berlin6699/2023-B/README.md

# 2023电赛B题
* 本题采用NE555振荡电路
* 实测精度1mm，最低测量7cm
* 成本低，速度快
* 一天半即可做完
