berlin6699/2023-B/项目介绍/项目介绍.pdf

### 电赛2023B题

任务

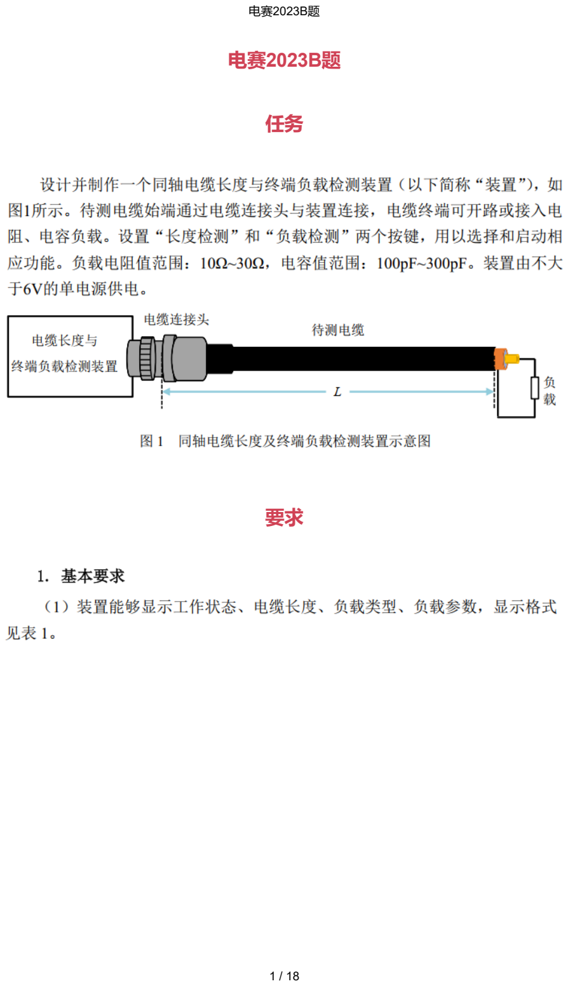
[picture p3: page 1]

要求

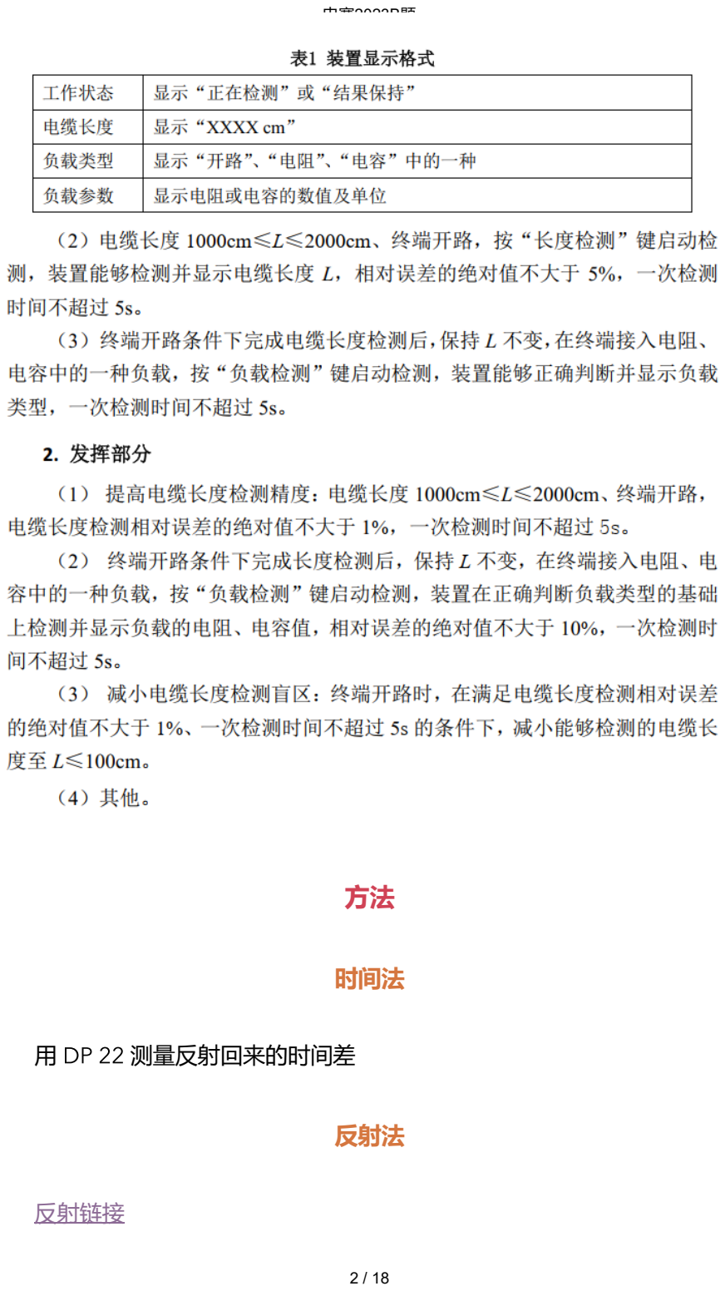
[picture p4: page 2]

方法

# 时间法

# 用 DP 22 测量反射回来的时间差

# 反射法

# 反射链接 (https://bbs.eeworld.com.cn/thread-1252184-1-1.html)

# 555 震荡法

# 最后选择的方法，事实证明非常好用，非常简单，非常精准

# 总的思想是先用 NE555 振荡出一个频率合适的方波（大概 100 多 k）， 再把传输线看成一个大电容（事实上理论就是如此）并联到 555 的电容端， 通过新振荡出来的频率来测量这时候传输线的长度

# 我们目前有三个量

# 这时候如果把 x 轴当作振荡频率，y 轴当作二者的乘积 那么可以发现，画出来的图形及其的线性 如下图所示 这个时候就可以通过频率精准的测出长度

线长

# 振荡频率 线长和震荡频率的乘积

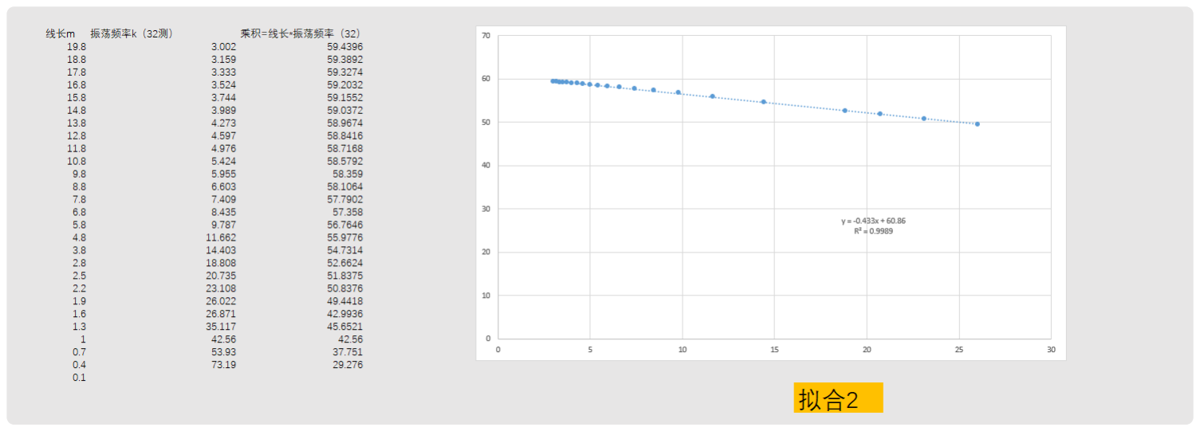
[picture p5: figure]

# 至于线缆单位长度的电容，也可以通过 NE555 的振荡公式算出来后进行

拟合

# 可以看到，R² 直接干到 1 了，很准，说明电缆等效电容分布很均匀

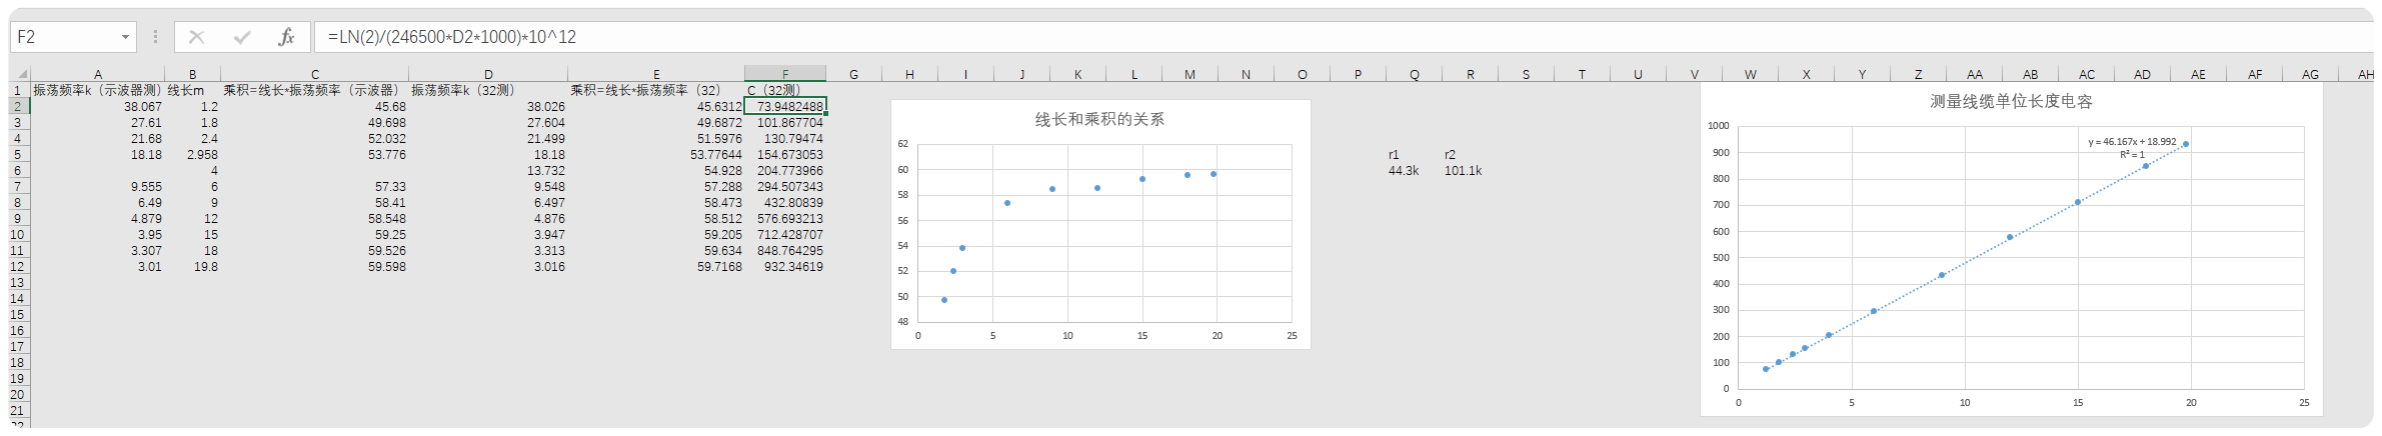
[picture p6: figure]

# 之后判断负载可以通过测量接入负载后的振荡频率来区分

# 振荡频率和接入前基本一致是开路 振荡频率比接入前低是电容 振荡频率变成 0 是电阻 代码如下

int judge_type(float connect_freq)

{

## //如果不震荡了，那就是接入了电阻

if(connect_freq == 0)

{

return r_flag;

}

## //如果频率和开路的基本频率基本一样，那么就是开路，这个容忍度是40kHz

else if((basic_freq-connect_freq)<40e3)

# 其他说明

{

return open_flag;

}

## //否则就是电容接入

else

{

return c_flag;

}

}

# 电容测量就根据变化的电容值来测量，接入电容相当于并联了电 容，直接换算成传输线的长度来运算，最后反解回电容

# 电阻测量就加入一个继电器，判断为电阻就切换一下测量电路，然 后根据分压法测量

# TIM 的捕获频率设置了 2 分频（84 MHz），这个频率越大那么频率测量 的就越精确，但没有取 1 分频是因为 168 M 太快了，会导致 65535 的 最大重装载溢出，造成某些低频无法测量，所以选择了 2 分频 还有一些拟合的数据见最后的整体代码

# 整体代码

# 宏定义

/* USER CODE BEGIN PD */

## //定义判断状态标志位

#define open_flag 0

#define c_flag 1

#define r_flag 2

## //定义连接负载板电容

#define add_C 1.9

## //定义基础开路震荡频率

#define basic_freq 132e3

## //乘积和振荡频率的一次函数关系

#define freq_slope -0.465

#define freq_intercept 60.803

## //线缆等效电容线密度

#define line_density_slope 46.167

#define line_density_intercept 18.992

## //定义分压测量电阻的串联已知电阻

# 全局变量

#define Rs 20.5

/* USER CODE END PD */

/* USER CODE BEGIN PV */

int time[3];

int i = 0;

int flag = 1;

## //定义第一次测量电路频率

double freq = 0;

## //定义第一次测量的乘积=线长*振荡频率

double sum = 0;

## //定义第一次测量线长

double length = 0;

## //定义第一次测量电缆的电容值

double C = 0;

## //定义接入负载后的振荡频率

double connect_freq = 0;

函数

# 自定义函数

double R_vol = 0;

## //负载类型判断

int type = 0;

/* USER CODE END PV */

/* USER CODE BEGIN PFP */

## //判断负载类型

int judge_type(float connect_freq);

## //第一次计算电缆长度

void calculate_length();

## //第二次计算

void recalculate();

/* USER CODE END PFP */

/* USER CODE BEGIN 4 */

int judge_type(float connect_freq)

{

## //如果不震荡了，那就是接入了电阻

if(connect_freq == 0)

{

return r_flag;

}

## //如果频率和开路的基本频率基本一样，那么就是开路，这个容忍度是40kHz

else if((basic_freq-connect_freq)<40e3)

{

return open_flag;

}

## //否则就是电容接入

else

{

return c_flag;

}

}

void calculate_length()

{

## //第一次计算，算出振荡频率、线长和等效电容

time[2]=time[1]-time[0];

printf("%d\r\n",time[2]);

freq= (84*1000000)/time[2];

printf("freq=%f k\r\n",freq/1000);

sum = freq_slope*freq/1000+freq_intercept;

length = sum/(freq/1000);

printf("length=%f\r\n",length);

C = length*46.167+18.992;

printf("C=%f\r\n",C);

}

void recalculate()

{

## //第二次计算，考虑到可能不震荡从而触发不了输入捕获，先把两个time置

零

time[1] = time[0] = 0;

i = 0;

__HAL_TIM_SET_COUNTER(&htim1,0);

HAL_Delay(1000);

# TIM 回调函数

time[2]=time[1]-time[0];

## //如果算出来是0，那说明没有触发输入捕获，这样就说明没有震荡，接入了

电阻

### if(time[2] == 0)

{

connect_freq = 0;

printf("电阻");

}

## //触发了输入捕获就是开路或者接入电容，可以算出来振荡频率

else

{

connect_freq= (84*1000000)/time[2];

}

}

/* USER CODE END 4 */

/* USER CODE BEGIN 0 */

void HAL_TIM_IC_CaptureCallback(TIM_HandleTypeDef *htim)

{

// __HAL_TIM_SET_COUNTER(&htim1,0);

if(i==0)

{

time[i] = HAL_TIM_ReadCapturedValue(&htim1, TIM_CHANNEL_3);

i++;

}

else if(i==1)

{

time[i] = HAL_TIM_ReadCapturedValue(&htim1, TIM_CHANNEL_3);

i++;

}

else

{

return;

}

# 主函数

}

/* USER CODE END 0 */

int main(void)

{

/* USER CODE BEGIN 1 */

/* USER CODE END 1 */

/* MCU Configuration----------------------------------------*/

/* Reset of all peripherals, Initializes the Flash interface

and the Systick. */

HAL_Init();

/* USER CODE BEGIN Init */

/* USER CODE END Init */

/* Configure the system clock */

SystemClock_Config();

/* USER CODE BEGIN SysInit */

/* USER CODE END SysInit */

/* Initialize all configured peripherals */

MX_GPIO_Init();

MX_USART1_UART_Init();

MX_DAC_Init();

MX_TIM3_Init();

MX_TIM1_Init();

/* USER CODE BEGIN 2 */

//初始化ADS8688

ADS8688_Init_Mult();

## //初始化定时器一些参数

HAL_TIM_Base_Start(&htim1);

HAL_TIM_IC_Start_IT(&htim1, TIM_CHANNEL_3);

__HAL_TIM_SET_COUNTER(&htim1,0);

## //初始化继电器

HAL_GPIO_WritePin(Relays_GPIO_Port, Relays_Pin, RESET);

/* USER CODE END 2 */

/* Infinite loop */

/* USER CODE BEGIN WHILE */

## //适当延时，使输入捕获频率测量完毕

HAL_Delay(1000);

## //计算第一次的参数：freq,C,length

calculate_length();

HAL_Delay(1000);

## //进行第二次计算

recalculate();

## //进行负载判断

type = judge_type(connect_freq);

if(type == c_flag)

{

## //计算连接后的乘积

double sum_connect = (-0.4052)*connect_freq/1000+60.846;

## //计算连接后的等效电缆长度

double length_connect = sum_connect/(connect_freq/1000);

## //根据电缆电容线密度，由等效长度算出等效电容大小

double C_connect =

length_connect*line_density_slope+line_density_intercept;

## //算出来的C不对，需要拟合得出正确的结果

double real_c = 2.0755*(C_connect-C-add_C)+8.7644;

printf("newC=%f\r\n",real_c);

}

else if(type == r_flag)

{

## //写后续切换继电器操作

HAL_GPIO_WritePin(Relays_GPIO_Port, Relays_Pin, SET);

HAL_Delay(100);

## //分压法测电阻阻值，用8688采集电压更准确

R_vol = get_vol(1);

printf("R_vol=%f\r\n",R_vol);

double R = (R_vol*Rs)/(5-R_vol);

printf("R=%f\r\n",R);

}

else

{

## //开路，什么也不操作

}

while (1)

{

}

/* USER CODE END WHILE */

/* USER CODE BEGIN 3 */

/* USER CODE END 3 */

}
