berlin6699/2023-B/软件/整体工程（带串口屏）/2023B/Core/Src/main.c

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
/* Includes ------------------------------------------------------------------*/
#include "main.h"
#include "dac.h"
#include "tim.h"
#include "usart.h"
#include "gpio.h"

/* USER CODE BEGIN Includes */
#include <stdio.h>
#include "math.h"
#include "arm_math.h"
#include "ADS8688.h"
#include "tjc_usart_hmi.h"

/* USER CODE END Includes */

/* USER CODE BEGIN PD */
//定义判断状态标志位
#define open_flag 0
#define c_flag 1
#define r_flag 2

//定义连接负载板电容
#define add_C 1.9

//定义基础开路振荡频率
#define basic_freq 132e3

//乘积和振荡频率的一次函数关关系
#define freq_slope -0.465
#define freq_intercept 60.803

//线缆等效电容线密度
#define line_density_slope 46.167
#define line_density_intercept 18.992

//定义分压测量电阻的串联已知电阻
#define Rs 20.5
/* USER CODE END PD */


/* USER CODE BEGIN PV */
int time[3];
int i = 0;
int flag = 1;

//定义第一次测量电路频率
double freq = 0;
//定义第一次测量的乘积=线长*振荡频率
double sum = 0;
//定义第一次测量线度
double length = 0;
//定义第一次测量电缆的电容值
double C = 0;

//定义接入负载后的振荡频率
double connect_freq = 0;

double R_vol = 0;
//负载类型判断
int type = 0;
/* USER CODE END PV */

void SystemClock_Config(void);
/* USER CODE BEGIN PFP */
//判断负载类型
int judge_type(float connect_freq);

//第一次计算电缆长度
void calculate_length();

//第二次计算
void recalculate();
/* USER CODE END PFP */

/* USER CODE BEGIN 0 */

void HAL_TIM_IC_CaptureCallback(TIM_HandleTypeDef *htim)
{
//	__HAL_TIM_SET_COUNTER(&htim1,0);

	if(i==0)
	{
		time[i] = HAL_TIM_ReadCapturedValue(&htim1, TIM_CHANNEL_3);
		i++;
	}
	else if(i==1)
	{
		time[i] = HAL_TIM_ReadCapturedValue(&htim1, TIM_CHANNEL_3);
		i++;
	}
	else
	{
		return;
	}

}
/* USER CODE END 0 */

/**
  * @brief  The application entry point.
  * @retval int
  */
int main(void)
{

  /* MCU Configuration--------------------------------------------------------*/

  /* Reset of all peripherals, Initializes the Flash interface and the Systick. */
  HAL_Init();

  /* Configure the system clock */
  SystemClock_Config();

  /* Initialize all configured peripherals */
  MX_GPIO_Init();
  MX_USART1_UART_Init();
  MX_DAC_Init();
  MX_TIM3_Init();
  MX_TIM1_Init();
  MX_USART3_UART_Init();
  /* USER CODE BEGIN 2 */
  //初始化ADS8688
  ADS8688_Init_Mult();
  initRingBuff();
  HAL_UART_Receive_IT(&huart3,RxBuff,1);
  //初始化继电器
  HAL_GPIO_WritePin(Relays_GPIO_Port, Relays_Pin, RESET);

  /* USER CODE END 2 */

  /* Infinite loop */
  /* USER CODE BEGIN WHILE */
//  //适当延时，使输入捕获频率测量完毕
//  HAL_Delay(1000);
//  //计算第一次的参数：freq,C,length
//  calculate_length();
//
//  HAL_Delay(1000);
//
//  //进行第二次计算
//  recalculate();
//  //进行负载判断
//  type = judge_type(connect_freq);
//
//  if(type == c_flag)
//  {
//	  //计算连接后的乘积
//	  double sum_connect = (-0.4052)*connect_freq/1000+60.846;
//	  //计算连接后的等效电缆长度
//	  double length_connect = sum_connect/(connect_freq/1000);
//	  //根据电缆电容线密度，由等效长度算出等效电容大小
//	  double C_connect = length_connect*line_density_slope+line_density_intercept;
//	  //算出来的C不对，需要拟合得出正确的结果
//	  double real_c = 2.0755*(C_connect-C-add_C)+8.7644;
//	  printf("newC=%f\r\n",real_c);
//  }
//  else if(type == r_flag)
//  {
//	 //写后续切换继电器操作
//  	 HAL_GPIO_WritePin(Relays_GPIO_Port, Relays_Pin, SET);
//  	 HAL_Delay(100);
//
//  	 //分压法测电阻阻值，ADS8688采集电压更准确
//  	 R_vol = get_vol(1);
//	 printf("R_vol=%f\r\n",R_vol);
//
// 	 double R = (R_vol*Rs)/(5-R_vol);
// 	 printf("R=%f\r\n",R);
//  }
//  else
//  {
//	  //开路，什么也不操作
//  }

    while (1)
  {

    	TJC_USART();//等待按键按下

  }


    /* USER CODE END WHILE */

}

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
/* USER CODE BEGIN 4 */
int judge_type(float connect_freq)
{
	//如果不震荡了，那就是接入了电阻
	if(connect_freq == 0)
	{
		return r_flag;
	}
	//如果频率和开路的基本频率基本一样，那么就是开路，这个容忍度是40kHz
	else if((freq-connect_freq)<4e3)
	{
		return open_flag;
	}
	//否则就是电容接入
	else
	{
		return c_flag;
	}
}


void calculate_length()
{
	//继电器复位
	HAL_GPIO_WritePin(Relays_GPIO_Port, Relays_Pin, RESET);

	//等待继电器稳定
	HAL_Delay(300);
	i = 0;
    HAL_TIM_Base_Start(&htim1);
    HAL_TIM_IC_Start_IT(&htim1, TIM_CHANNEL_3);
    __HAL_TIM_SET_COUNTER(&htim1,0);
    HAL_Delay(100);
	//第一次计算，算出振荡频率、线长和等效电容
	time[2]=time[1]-time[0];
	printf("%d\r\n",time[2]);
	freq= (84*1000000)/time[2];
	printf("freq=%f k\r\n",freq/1000);
	sum = freq_slope*freq/1000+freq_intercept;
	length = sum/(freq/1000);
	printf("length=%f\r\n",length);
	C = length*46.167+18.992;
	printf("C=%f\r\n",C);
	HAL_TIM_Base_Stop(&htim1);
	HAL_TIM_IC_Stop_IT(&htim1, TIM_CHANNEL_3);
}

void recalculate()
{
	//第二次计算，考虑到可能不振荡从而触发不了输入捕获，先把两个time置零
	time[1] = time[0] = 0;
	i = 0;
    HAL_TIM_Base_Start(&htim1);
    HAL_TIM_IC_Start_IT(&htim1, TIM_CHANNEL_3);
    __HAL_TIM_SET_COUNTER(&htim1,0);

	HAL_Delay(100);
	time[2]=time[1]-time[0];

	//如果算出来是0，那说明没有触发输入捕获，这样就说明没有震荡，接入了电阻
	if(time[2] == 0)
	{
		connect_freq = 0;
		printf("电阻");
	}
	//触发了输入捕获就是开路或者接入电容，可以算出来振荡频率
	else
	{
		connect_freq= (84*1000000)/time[2];
	}
	HAL_TIM_Base_Stop(&htim1);
	HAL_TIM_IC_Stop_IT(&htim1, TIM_CHANNEL_3);
}

void TJC_USART()
{
	while (usize >= 6)
	{
		// 校验帧头帧尾是否匹配
		if (u(0) != 0x55 || u(3) != 0xff || u(4) != 0xff || u(5) != 0xff)
		{
			// 不匹配删除1字节
			udelete(1);
		}
		else
		{
			// 匹配，跳出循环
			break;
		}
	}

	// 进行解析
	if (usize >= 6 && u(0) == 0x55 && u(3) == 0xff && u(4) == 0xff&& u(5) == 0xff)
	{
		if ((u(1) == 0x00))
		{ // 长度检测
			TJCPrintf("t5.txt=\"正在检测\"");
			TJCPrintf("x1.val=%d",(int)(0*100));
			TJCPrintf("t8.txt=\" \"");
			TJCPrintf("t6.txt=\"开路\"");
			calculate_length();
			TJCPrintf("t5.txt=\"结果保持\"");
			TJCPrintf("x0.val=%d",(int)(length * 10000));

		}
		else if (u(1) == 0x01)
		{ // 负载检测
			TJCPrintf("t5.txt=\"正在检测\"");
			recalculate();
			type = judge_type(connect_freq);

			  if(type == c_flag)
			  {
				  //计算连接后的乘积
				  double sum_connect = (-0.4052)*connect_freq/1000+60.846;
				  //计算连接后的等效电缆长度
				  double length_connect = sum_connect/(connect_freq/1000);
				  //根据电缆电容线密度，由等效长度算出等效电容大小
				  double C_connect = length_connect*line_density_slope+line_density_intercept;
				  //算出来的C不对，需要拟合得出正确的结果
				  double real_c = (2.0755*(C_connect-C-add_C)+8.7644)*1.0081-16.524;
				  printf("newC=%f\r\n",real_c);
				  TJCPrintf("t6.txt=\"电容\"");
				  TJCPrintf("x1.val=%d",(int)(real_c * 100));
				  TJCPrintf("t8.txt=\"pF\"");
				  TJCPrintf("t5.txt=\"结果保持\"");
			  }
			  else if(type == r_flag)
			  {
				 //写后续切换继电器操作
			  	 HAL_GPIO_WritePin(Relays_GPIO_Port, Relays_Pin, SET);
			  	 HAL_Delay(100);

			  	 //分压法测电阻阻值，ADS8688采集电压更准确
			  	 R_vol = get_vol(1);
				 printf("R_vol=%f\r\n",R_vol);

			 	 double R = ((R_vol*Rs)/(5-R_vol))*0.98+0.1234;
			 	 printf("R=%f\r\n",R);
			 	 TJCPrintf("t6.txt=\"电阻\"");
			 	 TJCPrintf("x1.val=%d",(int)(R*100));
			 	 TJCPrintf("t8.txt=\"Ω\"");
			 	 TJCPrintf("t5.txt=\"结果保持\"");
			  }
			  else
			  {
				  TJCPrintf("x1.val=%d",(int)(0*100));
				  TJCPrintf("t8.txt=\" \"");
				  TJCPrintf("t6.txt=\"开路\"");
				  TJCPrintf("t5.txt=\"结果保持\"");
				  //开路，什么也不操作
			  }
		}
		udelete(6);
	}
}

/* USER CODE END 4 */
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
