berlin6699/2023-B/软件/整体工程（不带串口屏）/2023B/Core/Inc/main.h

#define LED0_Pin GPIO_PIN_9
#define LED0_GPIO_Port GPIOF
#define LED1_Pin GPIO_PIN_10
#define LED1_GPIO_Port GPIOF
#define Relays_Pin GPIO_PIN_12
#define Relays_GPIO_Port GPIOD
#define ADS_RST_Pin GPIO_PIN_9
#define ADS_RST_GPIO_Port GPIOC
#define ADS_DAISY_Pin GPIO_PIN_8
#define ADS_DAISY_GPIO_Port GPIOA
#define ADS_SDO_Pin GPIO_PIN_11
#define ADS_SDO_GPIO_Port GPIOA
#define ADS_SDI_Pin GPIO_PIN_12
#define ADS_SDI_GPIO_Port GPIOA
#define ADS_nCS_Pin GPIO_PIN_15
#define ADS_nCS_GPIO_Port GPIOA
#define ADS_SCLK_Pin GPIO_PIN_10
#define ADS_SCLK_GPIO_Port GPIOC
#define KEY1_Pin GPIO_PIN_8
#define KEY1_GPIO_Port GPIOB
#define KEY0_Pin GPIO_PIN_9
#define KEY0_GPIO_Port GPIOB
