berlin6699/2023-B/软件/整体工程（不带串口屏）/2023B/ADS8688/ADS8688.c

#include "ADS8688.h"
#include "gpio.h"

uint16_t My_Ad[8]={0,0,};
float ad_real[2]={0.0,0.0};
uint8_t test;

void ADS8688_SPI_WB(uint8_t com)
{
	uint8_t com_temp=com,s;
	ADS_8688_nCS_L;
	for(s=0;s<8;s++)
	{
		if(com_temp&0x80)
		{
			ADS_8688_SDI_H;
		}
		else
		{
			ADS_8688_SDI_L;
		}
	ADS_8688_SCLK_H;
	com_temp<<=1;
	ADS_8688_SCLK_L;
	}
}


uint8_t ADS8688_SPI_RB(void)
{
	uint8_t Rdata=0,s;
	//ADS_8688_nCS_L;
	for(s=0;s<8;s++)
	{
		Rdata<<=1;
		ADS_8688_SCLK_H;
		if(ADS_8688_SDO)
		{
			Rdata|=0x01;
		}
		else
		{
			Rdata&=0xFE;
		}
	ADS_8688_SCLK_L;
	}
	return Rdata;
}


void ADS8688_WriteCommandReg(uint16_t command)//写ADS8688命令寄存器
{
	ADS_8688_nCS_L;
	ADS8688_SPI_WB(command>>8 & 0XFF);
	ADS8688_SPI_WB(command & 0XFF);
	ADS_8688_nCS_H;
}


void ADS8688_Write_Program_Register(uint8_t Addr,uint8_t data)
{
	ADS_8688_nCS_L;
	ADS8688_SPI_WB(Addr<<1| 0X01);
	ADS8688_SPI_WB(data);
	ADS_8688_nCS_H;
}


uint8_t ADS8688_READ_Program_Register(uint8_t Addr)
{
	uint8_t data = 0;
	ADS_8688_nCS_L;
	ADS8688_SPI_WB(Addr<<1);
	data = ADS8688_SPI_RB();
	data = ADS8688_SPI_RB();
	ADS_8688_nCS_H;
	return data;
}


 void Enter_RESET_MODE(void)//软件复位模式，复位 program registers
{
 ADS8688_WriteCommandReg(RST);
}

void AUTO_RST_Mode(void)//进入自动扫描模式
{
	ADS8688_WriteCommandReg(AUTO_RST);
}

void MAN_Ch_n_Mode(uint16_t ch)//手动模式
{
	ADS8688_WriteCommandReg(ch);
}

void Set_CH_Range_Select(uint8_t ch,uint8_t range) //设置各个通道的范围
{
	ADS8688_Write_Program_Register(ch,range);
}

void Get_AUTO_RST_Mode_Data(uint16_t* outputdata, uint8_t chnum)
{
	//读取扫描通道序列的AD转换数据code到变量数组中
	uint8_t i=0,datal=0,datah=0;
	uint16_t data=0;
	for (i=0; i<chnum; i++)
	{
		ADS_8688_nCS_L;
		ADS8688_SPI_WB(0X00);
		ADS8688_SPI_WB(0X00);
		datah = ADS8688_SPI_RB();
		datal = ADS8688_SPI_RB();
		ADS_8688_nCS_H;
		data = datah<<8 | datal; //低位在前，低位在后
		*(outputdata+i) = data;
	}
}

//初始化通道1，默认正负10V范围
/*void ADS8688_Init_Single()
{
	ADS_8688_RST_PD_L;
	HAL_Delay(2);
	ADS_8688_RST_PD_H;
	ADS_8688_DAISY_IN_L;
	Enter_RESET_MODE();
	ADS8688_Write_Program_Register(0X01,0Xff);
	ADS8688_READ_Program_Register(0X01);
	HAL_Delay(2);
	ADS8688_Write_Program_Register(0x02,0x00);//所有通道退出低功耗状态
	ADS8688_Write_Program_Register(0x01,0xff);//使能所有通道
	Set_CH_Range_Select(CH1,0x00);//设置通道1的输?范围：+-2.5*Vref
	// //0x00 -> +-2.5*ref
	// //0x01 -> +-1.25*ref
	// //0x02 -> +-0.625*ref
	// //0x03 -> +2.5*ref
	// //0x04 -> +1.25*ref
	MAN_Ch_n_Mode(MAN_Ch_1);
	//HAL_Delay(300);
 }
*/
 void ADS8688_Init_Mult(void)
{
	MX_GPIO_Init();
	ADS_8688_RST_PD_H;
	ADS_8688_DAISY_IN_L;
	test=ADS8688_INIT();
	//Enter_RESET_MODE();
	//进入配置
	//ADS8688_Write_Program_Register(0X00,0X00);
	//开启通道
	ADS8688_Write_Program_Register(0X02,0Xfc);
	ADS8688_Write_Program_Register(0x01,0x03);//所有通道退出低功耗状态


	Set_CH_Range_Select(CH1,0x01);//设置通道1的输入范围：+-1.25*Vref
	Set_CH_Range_Select(CH2,0x01);


	/*
	Set_CH_Range_Select(CH2,0x00);
	Set_CH_Range_Select(CH3,0x00);
	Set_CH_Range_Select(CH4,0x00);
	Set_CH_Range_Select(CH5,0x00);
	Set_CH_Range_Select(CH6,0x00);
	Set_CH_Range_Select(CH7,0x00);

	*/
	//ref==4.096
	// //0x00 -> +-2.5*ref
	// //0x01 -> +-1.25*ref
	// //0x02 -> +-0.625*ref
	// //0x03 -> +2.5*ref
	// //0x04 -> +1.25*ref
	//AUTO_RST_Mode();//进入自动扫描模式
	//ADS8688_Write_Program_Register(0xa0,0x03);
	HAL_Delay(10);
  AUTO_RST_Mode();

}

 uint8_t ADS8688_INIT(void)
 {
   uint8_t i;
 //	RST_PD_H;
 //  DAISY_IN_L;


   Enter_RESET_MODE();
   ADS8688_Write_Program_Register(0X01,0XFF);
   i = ADS8688_READ_Program_Register(0X01);
   return i;
 }




uint16_t Get_MAN_Ch_n_Mode_Data(void)
{
	uint8_t datah=0,datal=0;
	ADS_8688_nCS_L;
	ADS8688_SPI_WB(0X00);
	ADS8688_SPI_WB(0X00);
	datah = ADS8688_SPI_RB();
	datal = ADS8688_SPI_RB();
	ADS_8688_nCS_H;
	return (datah<<8 | datal);
}
uint16_t get_ADS_ch1(void)
{
	return Get_MAN_Ch_n_Mode_Data();//读取通道1数据,具体通道数由函数 MAN_Ch_n_Mode()所决定的
}

void get_ch1andch2(float *real_val)
{
	  uint16_t get_val[2];
	  MAN_Ch_n_Mode(MAN_Ch_1);
	  get_val[0]=Get_MAN_Ch_n_Mode_Data();//获取通道1的值
	  MAN_Ch_n_Mode(MAN_Ch_2);
	  get_val[1]=Get_MAN_Ch_n_Mode_Data();//获取通道2的值
	  real_val[0]=(float)((double)(get_val[0]-32762)/32767.0f*5.120f);
	  real_val[1]=(float)((double)(get_val[1]-32762)/32767.0f*5.120f);
}

float get_vol(uint16_t channel)
{
  switch(channel)
  {
    case 0:
	  MAN_Ch_n_Mode(MAN_Ch_1);
	  uint16_t val1  = Get_MAN_Ch_n_Mode_Data();//获取通道0的值
	  return (float)((double)(val1-32762)/32767.0f*5.120f);
	  break;
	case 1:
	  MAN_Ch_n_Mode(MAN_Ch_2);
	  uint16_t val2 = Get_MAN_Ch_n_Mode_Data();//获取通道1的值
	  return (float)((double)(val2-32762)/32767.0f*5.120f);
	  break;
	case 2:
	  MAN_Ch_n_Mode(MAN_Ch_3);
	  uint16_t val3 = Get_MAN_Ch_n_Mode_Data();//获取通道2的值
	  return (float)((double)(val3-32762)/32767.0f*5.120f);
	  break;
	case 3:
	  MAN_Ch_n_Mode(MAN_Ch_4);
	  uint16_t val4 = Get_MAN_Ch_n_Mode_Data();//获取通道3的值
	  return (float)((double)(val4-32762)/32767.0f*5.120f);
	  break;
	case 4:
	  MAN_Ch_n_Mode(MAN_Ch_5);
	  uint16_t val5 = Get_MAN_Ch_n_Mode_Data();//获取通道4的值
	  return (float)((double)(val5-32762)/32767.0f*5.120f);
	  break;
	case 5:
	  MAN_Ch_n_Mode(MAN_Ch_6);
	  uint16_t val6 = Get_MAN_Ch_n_Mode_Data();//获取通道5的值
	  return (float)((double)(val6-32762)/32767.0f*5.120f);
	  break;
	case 6:
	  MAN_Ch_n_Mode(MAN_Ch_7);
	  uint16_t val7 = Get_MAN_Ch_n_Mode_Data();//获取通道6的值
	  return (float)((double)(val7-32762)/32767.0f*5.120f);
	  break;
	case 7:
	  MAN_Ch_n_Mode(MAN_Ch_8);
	  uint16_t val8 = Get_MAN_Ch_n_Mode_Data();//获取通道7的值
	  return (float)((double)(val8-32762)/32767.0f*5.120f);
	  break;
	default:
	  return 123.456;
  }
}
