berlin6699/2023-B/软件/整体工程（不带串口屏）/2023B/Core/Src/usart.c

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
/* Includes ------------------------------------------------------------------*/
#include "usart.h"

/* USER CODE BEGIN 0 */
#include <stdio.h>
/* USER CODE END 0 */

UART_HandleTypeDef huart1;

/* USART1 init function */

void MX_USART1_UART_Init(void)
{

  huart1.Instance = USART1;
  huart1.Init.BaudRate = 115200;
  huart1.Init.WordLength = UART_WORDLENGTH_8B;
  huart1.Init.StopBits = UART_STOPBITS_1;
  huart1.Init.Parity = UART_PARITY_NONE;
  huart1.Init.Mode = UART_MODE_TX_RX;
  huart1.Init.HwFlowCtl = UART_HWCONTROL_NONE;
  huart1.Init.OverSampling = UART_OVERSAMPLING_16;
  if (HAL_UART_Init(&huart1) != HAL_OK)
  {
    Error_Handler();
  }
}

void HAL_UART_MspInit(UART_HandleTypeDef* uartHandle)
{

  GPIO_InitTypeDef GPIO_InitStruct = {0};
  if(uartHandle->Instance==USART1)
  {
    /* USART1 clock enable */
    __HAL_RCC_USART1_CLK_ENABLE();

    __HAL_RCC_GPIOA_CLK_ENABLE();
    /**USART1 GPIO Configuration
    PA9     ------> USART1_TX
    PA10     ------> USART1_RX
    */
    GPIO_InitStruct.Pin = GPIO_PIN_9|GPIO_PIN_10;
    GPIO_InitStruct.Mode = GPIO_MODE_AF_PP;
    GPIO_InitStruct.Pull = GPIO_NOPULL;
    GPIO_InitStruct.Speed = GPIO_SPEED_FREQ_VERY_HIGH;
    GPIO_InitStruct.Alternate = GPIO_AF7_USART1;
    HAL_GPIO_Init(GPIOA, &GPIO_InitStruct);

  }
}

void HAL_UART_MspDeInit(UART_HandleTypeDef* uartHandle)
{

  if(uartHandle->Instance==USART1)
  {
    /* Peripheral clock disable */
    __HAL_RCC_USART1_CLK_DISABLE();

    /**USART1 GPIO Configuration
    PA9     ------> USART1_TX
    PA10     ------> USART1_RX
    */
    HAL_GPIO_DeInit(GPIOA, GPIO_PIN_9|GPIO_PIN_10);

  }
}

/* USER CODE BEGIN 1 */
#ifdef __GNUC__

#define PUTCHAR_PROTOTYPE int __io_putchar(int ch)

#define GETCHAR_PROTOTYPE int __io_getchar(FILE *f)

#else

#define PUTCHAR_PROTOTYPE int fputc(int ch, FILE *f)

#define GETCHAR_PROTOTYPE int fgetc(FILE *f)

#endif /* __GNUC__ */

PUTCHAR_PROTOTYPE
{
	HAL_UART_Transmit(&huart1, (uint8_t *)&ch, 1, 0xFFFF);

	return ch;
}

GETCHAR_PROTOTYPE
{
	uint8_t ch = 0;
	HAL_UART_Receive(&huart1,(uint8_t *)&ch, 1, 0xFFFF);

	if (ch == '\r')
	{
		__io_putchar('\r');
		ch = '\n';
	}


	return __io_putchar(ch);
}
/* USER CODE END 1 */
