berlin6699/2023-B/(notices)

Notices in the files:
软件/整体工程（不带串口屏）/2023B/Core/Inc/main.h:
Copyright (c) 2023 STMicroelectronics.
All rights reserved.
This software is licensed under terms that can be found in the LICENSE file
